Skitter-JP/Edison_Light_Dimmer/Images/home-kit.jpg

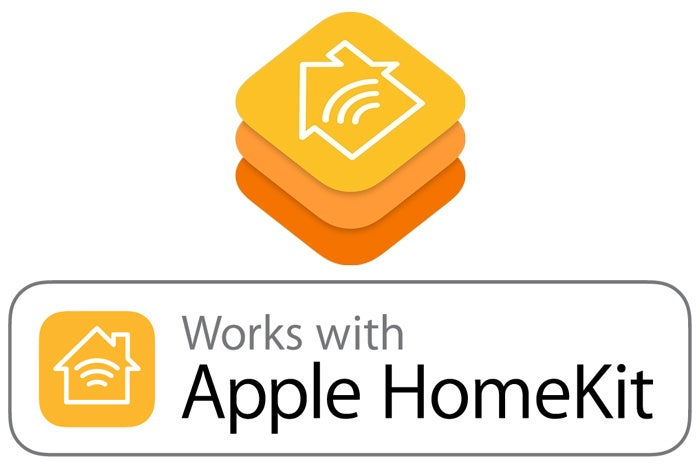
Images/home-kit.jpg
