Skitter-JP/Edison_Light_Dimmer/Images/IMG_0295.JPG

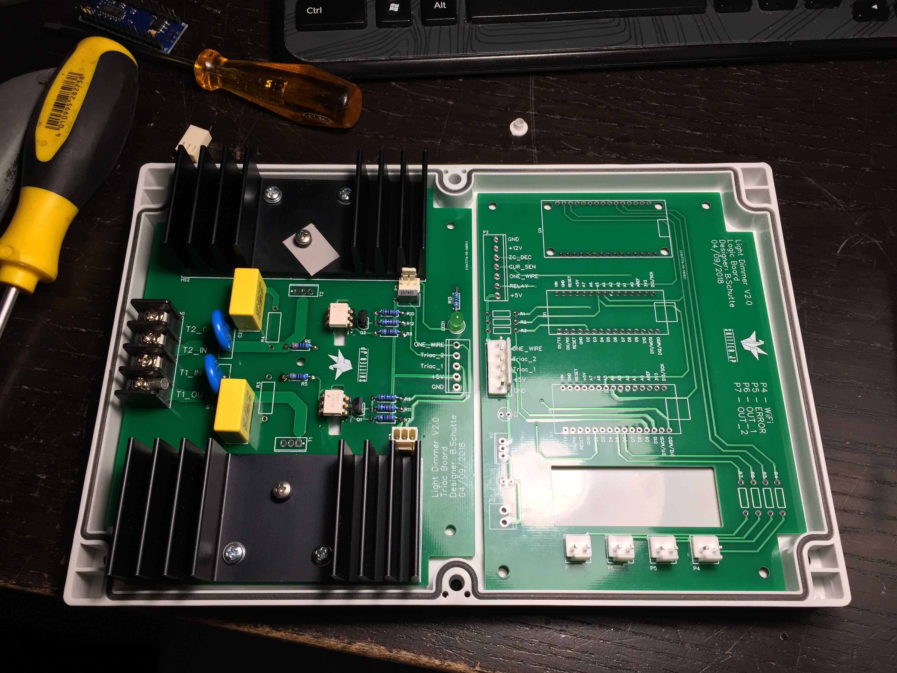
Images/IMG_0295.JPG
