Skitter-JP/Edison_Light_Dimmer/Images/Light_Dimmer_Gif.gif

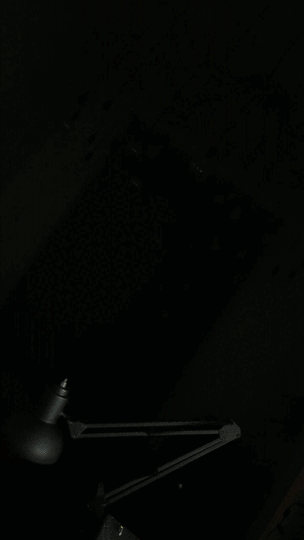
Images/Light_Dimmer_Gif.gif
