Skitter-JP/Edison_Light_Dimmer/Images/Power_control_and_PSU_and_filter.JPG

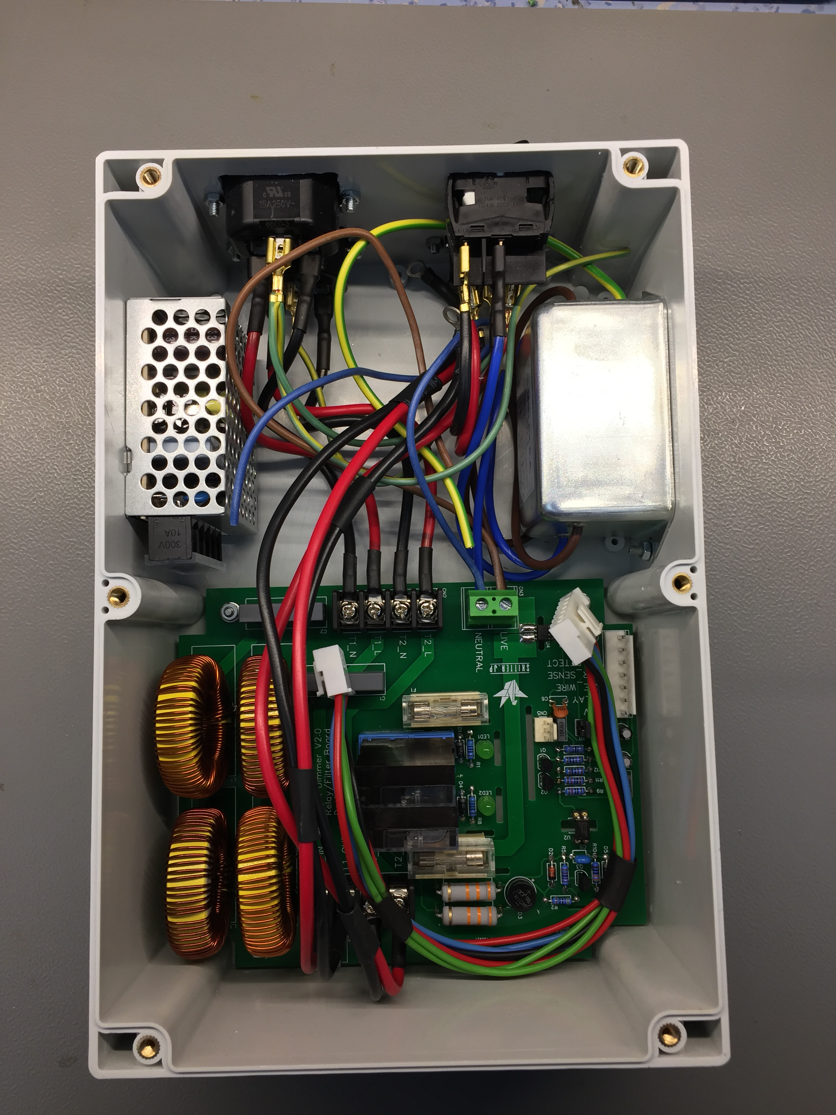
Images/Power_control_and_PSU_and_filter.JPG
