Skitter-JP/Edison_Light_Dimmer/Schematics/Schematic_Light-Dimmer-V2.0-Power-Control_Power-Controls_20180926231436.pdf

+5V

+12V

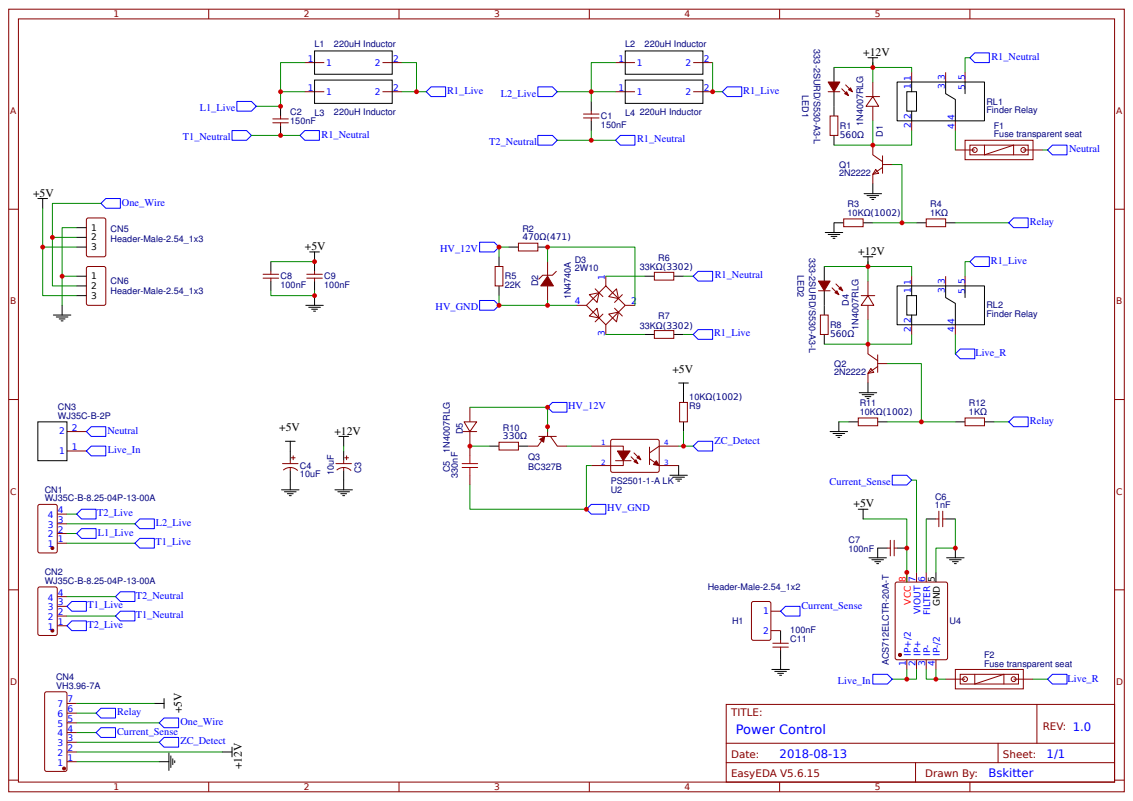
[picture p19: page 1]

IP-/2 4 GND 5 FILTER 6 VIOUT 7 VCC 8
