Skitter-JP/Edison_Light_Dimmer/Schematics/Schematic_Light-Dimmer-V2.0-Triac-Circuit_Triac-Schematic_20180926231358.pdf

+5V

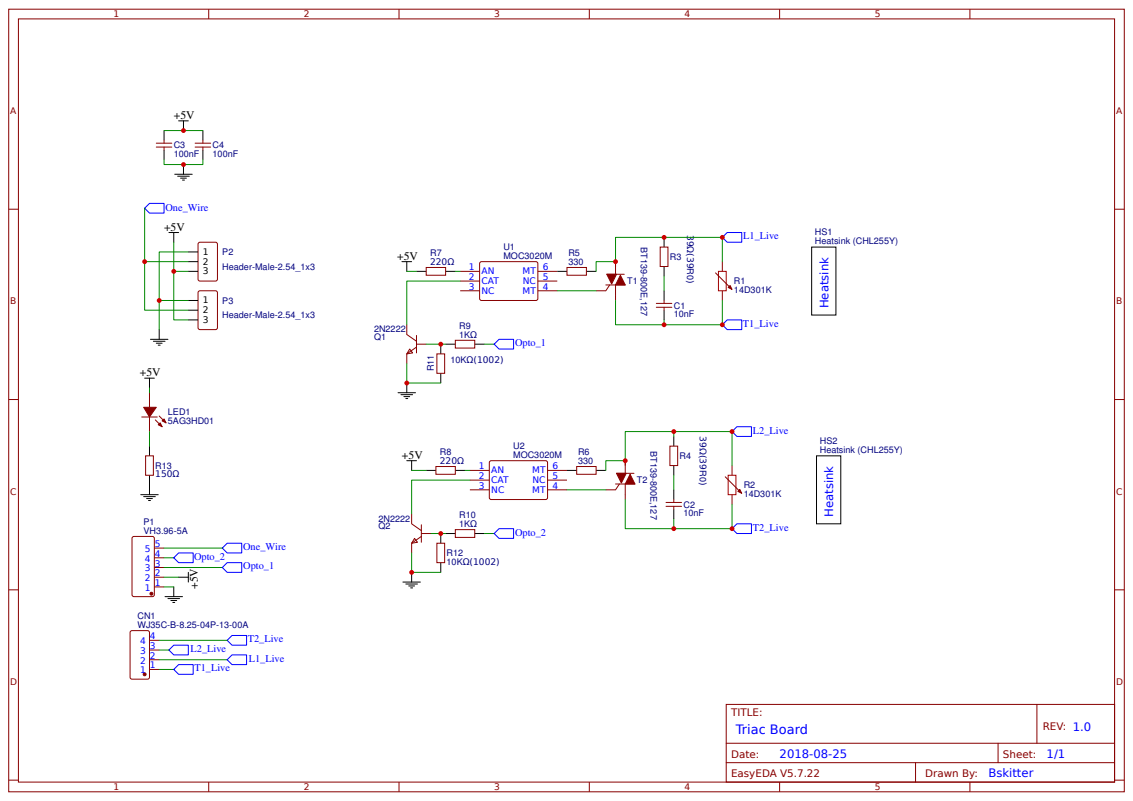
[picture p20: page 1]
