Skitter-JP/Edison_Light_Dimmer/Schematics/Schematic_Light-Dimmer-V2.1-Control-Unit_Logic_20190226212939.pdf

+12V

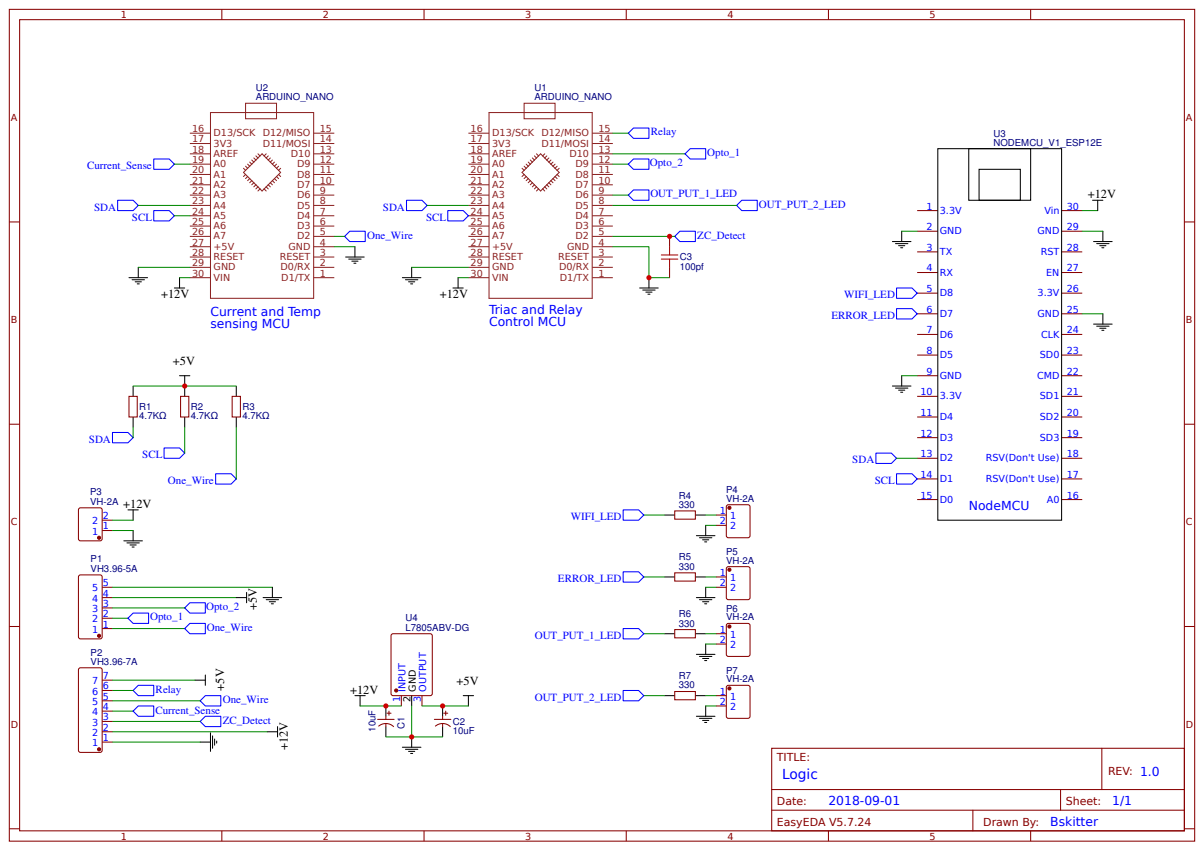
[picture p21: page 1]
