Skitter-JP/Edison_Light_Dimmer/PCBs/PCB_Logic_V1.2_20190728215613.pdf

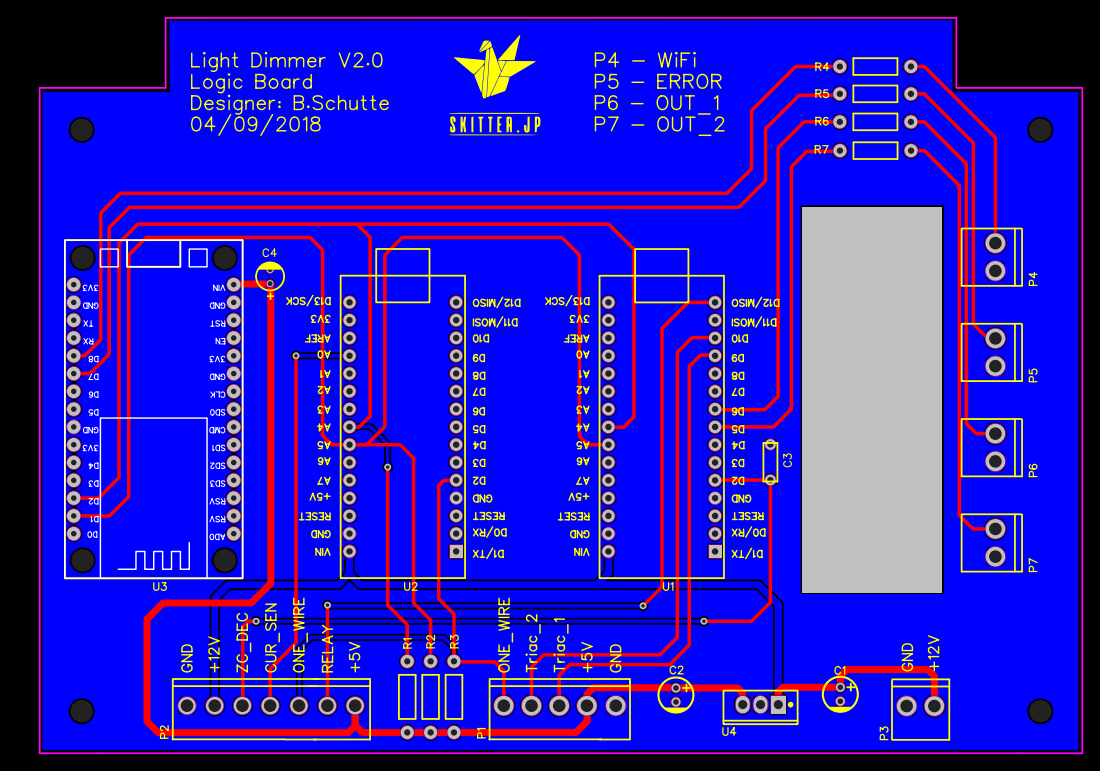
[picture p22: page 1]
