Skitter-JP/Edison_Light_Dimmer/PCBs/PCB_Power-Controls_V1.0_20180926230958.pdf

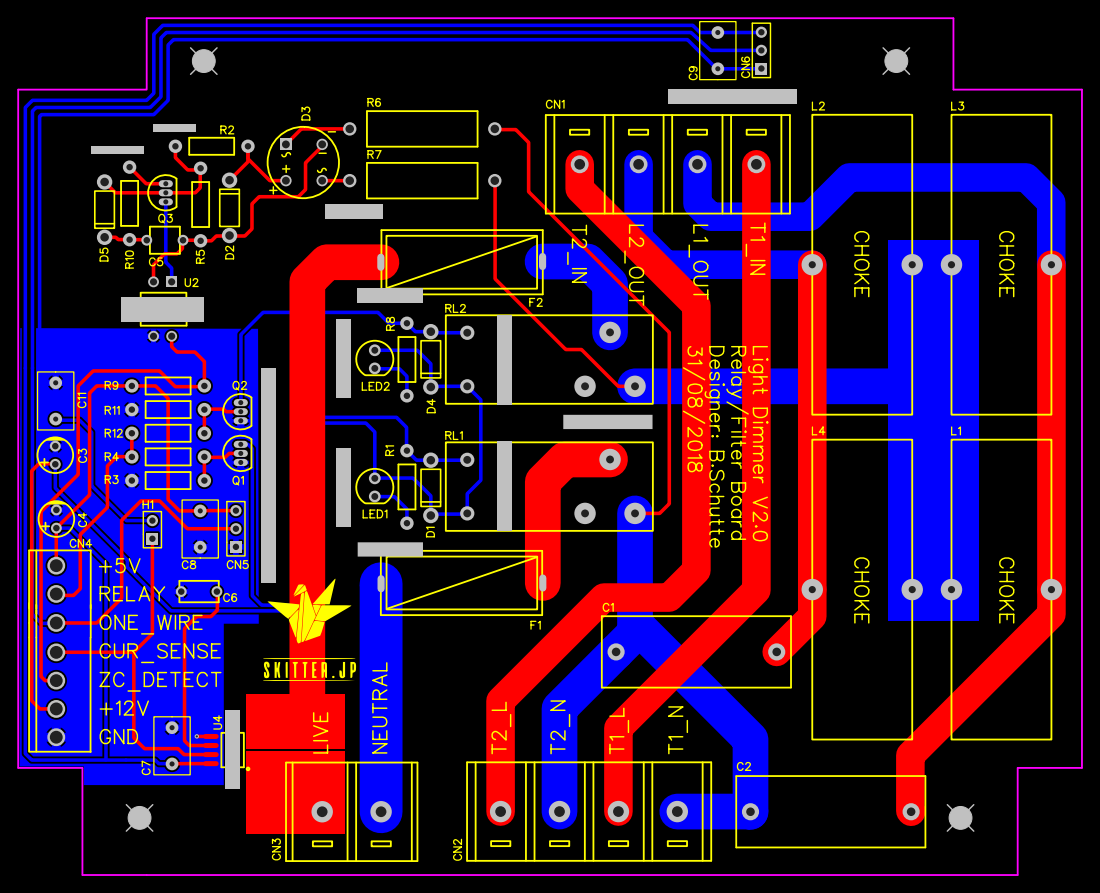
[picture p23: page 1]
