Skitter-JP/Edison_Light_Dimmer/PCBs/PCB_Triac-PCB-2_V1.0_20180926231028.pdf

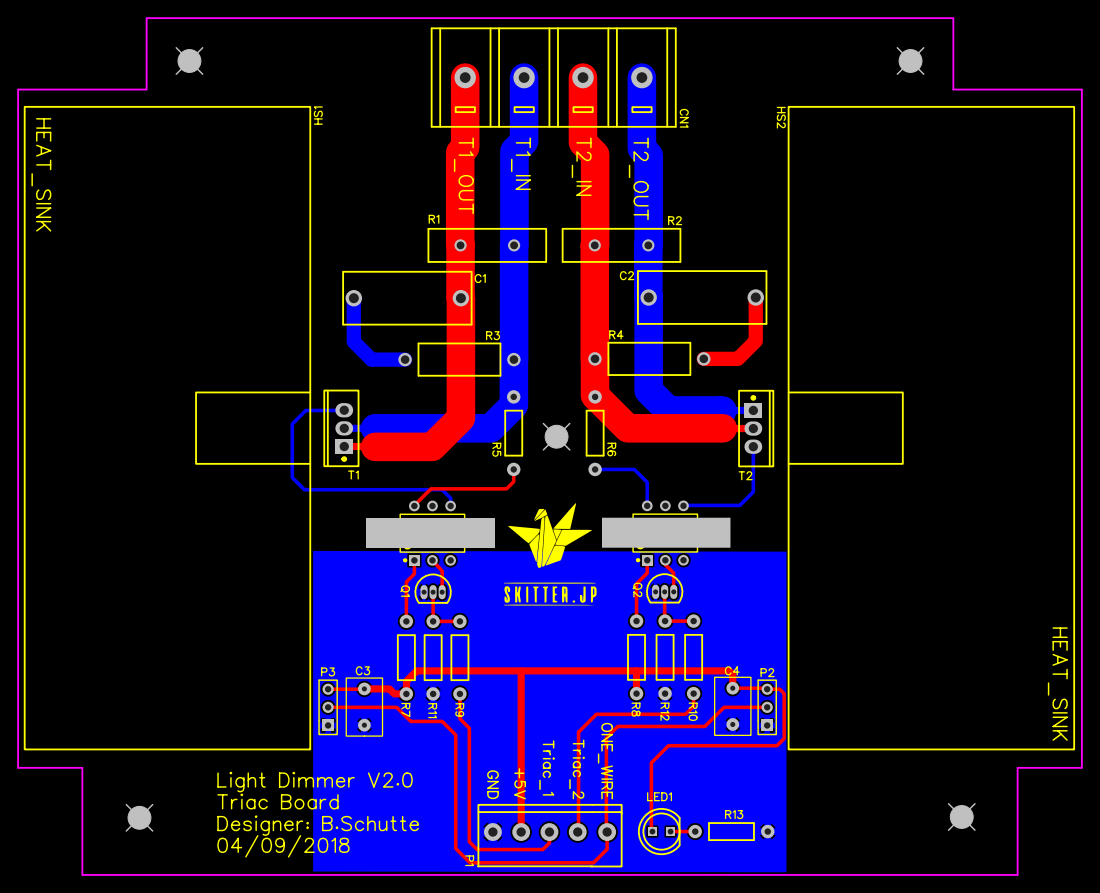
[picture p24: page 1]
